adambdia/porch-light/README.md

# Porch Light Controller

My porch light drifts over time, getting out of sync. Probably because it's old. This is my attempt to IOT-ify it.
