adambdia/porch-light/pcb/porch-light-pcb.kicad_pcb

## KiCad design pcb/porch-light-pcb.kicad_pcb (2026-08-08)

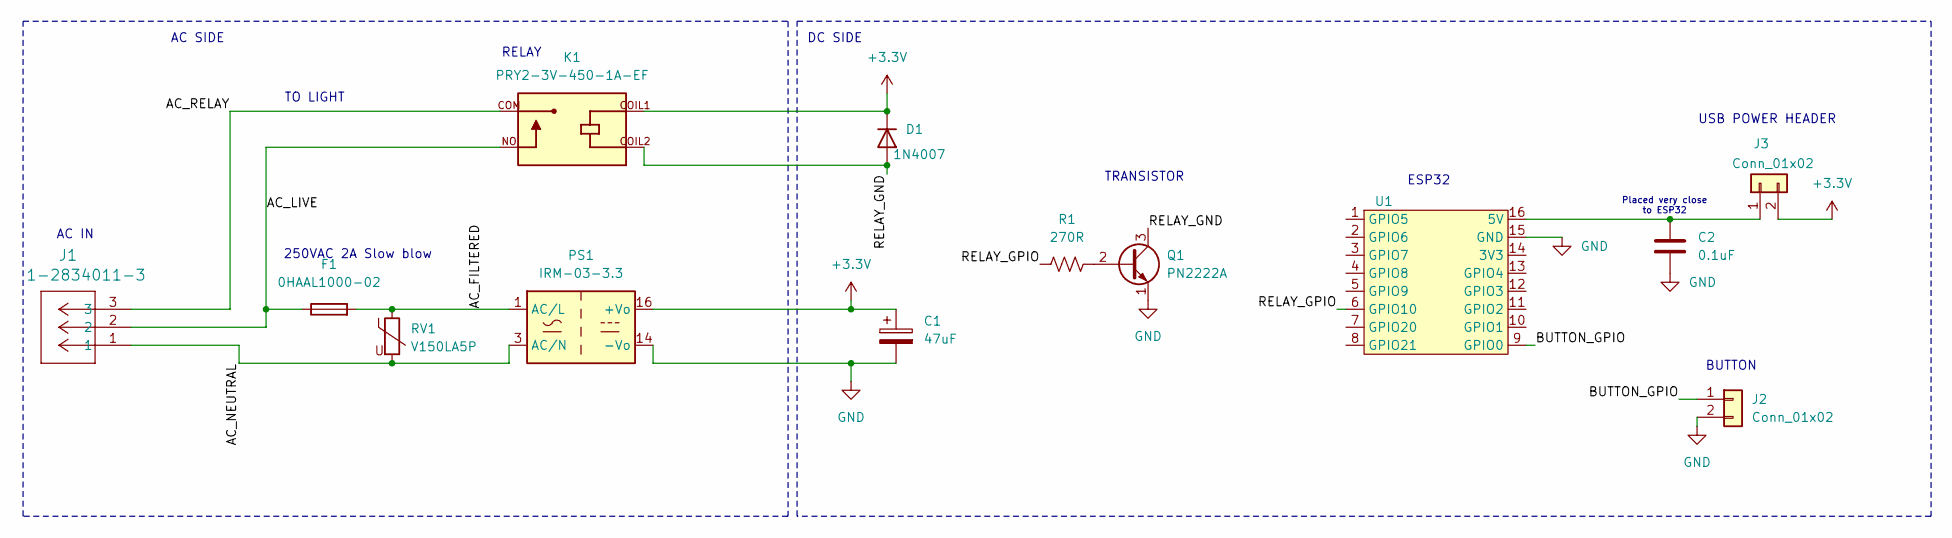
[picture p1: schematic porch-light-pcb.kicad_sch]

Parts:
C1: 47uF; CP_Radial_D4.0mm_P1.50mm
C2: 0.1uF; C_0603_1608Metric_Pad1.08x0.95mm_HandSolder
D1: 1N4007; D_SOD-123F
F1: 0HAAL1000-02; FUSRR508W60L840T400H810B
J1: 1-2834011-3; CONN_1-2834011-3_TEC
J2, J3: Conn_01x02; PinHeader_1x02_P2.54mm_Vertical
K1: PRY2-3V-450-1A-EF; RELAY_PRY2-3V-450-1A-EF; PARTREV 1.0
PS1: IRM-03-3.3; Converter_ACDC_MeanWell_IRM-03-xx_THT
Q1: PN2222A; TO-92_Inline
R1: 270R; R_Axial_DIN0207_L6.3mm_D2.5mm_P10.16mm_Horizontal
RV1: V150LA5P; RV_Disc_D12mm_W5.8mm_P7.5mm
U1: TENSTAR_ESP32-C3-SUPERMINI

Connections:
+3.3V: C1.1, D1.1 (K), J3.2, K1.COIL1, PS1.16 (+Vo)
/AC_FILTERED: F1.2, PS1.1 (AC/L), RV1.1
/AC_LIVE: F1.1, J1.2, K1.NO
/AC_NEUTRAL: J1.1, PS1.3 (AC/N), RV1.2
/AC_RELAY: J1.3, K1.COM
/BUTTON_GPIO: J2.1, U1.9 (GPIO0)
/RELAY_GND: D1.2 (A), K1.COIL2, Q1.3 (C)
/RELAY_GPIO: R1.1, U1.6 (GPIO10)
GND: C1.2, C2.1, J2.2, PS1.14 (-Vo), Q1.1 (E), U1.15 (GND)
unnamed: C2.2, J3.1, U1.16 (5V)
unnamed: Q1.2 (B), R1.2

Notes on the sheet:
RELAY
Placed very close to ESP32
TO LIGHT
DC SIDE
USB POWER HEADER
TRANSISTOR
AC SIDE
250VAC 2A Slow blow
ESP32
AC IN
BUTTON

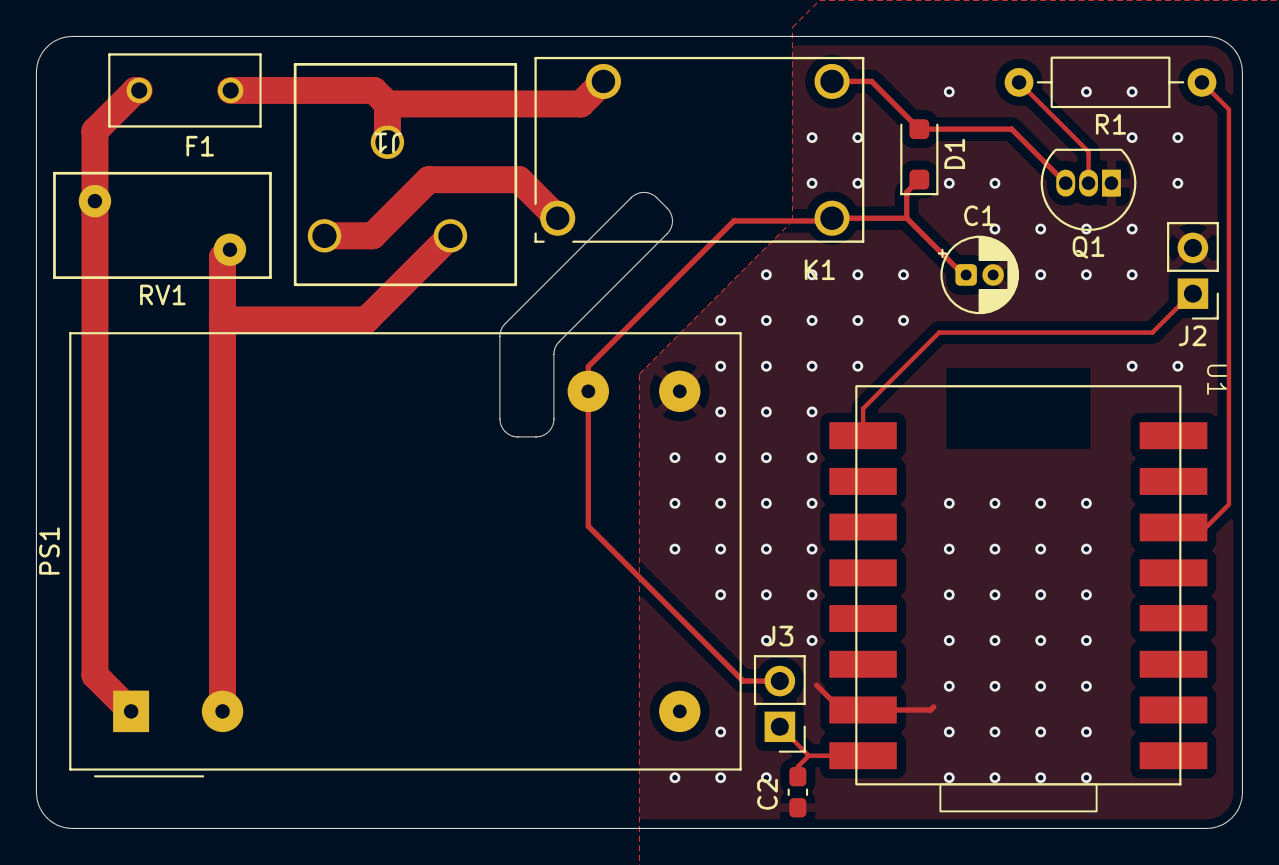
[picture p2: board porch-light-pcb.kicad_pcb from above]

Board: 2 copper layers, 67.0 x 44.0 mm, 13 parts (0 on the bottom side), 11 nets.
