adambdia/porch-light/fw/src/Light.cpp

#include "Light.h"
#include "esp32-hal-gpio.h"
#include "esp32-hal.h"
#include <Arduino.h>
#include <cstdint>

static int relayPin = 10;
static int LEDPin = 8; // onboard LED, for debug
static volatile bool scheduleLightEnabled = false;
static volatile uint32_t lightOverrideDuration = 10 * 60 * 1000; //  10 minutes
static volatile time_t lightOverrideExpireTime = 0;
static volatile bool lightOverrideEnabled = false;
static volatile uint32_t lastLightOverride = 0;

void initLight() {
  pinMode(relayPin, OUTPUT);
  pinMode(LEDPin, OUTPUT);
}

void turnOnLight() {
  digitalWrite(relayPin, HIGH);
  digitalWrite(LEDPin, LOW);
}

void turnOffLight() {
  digitalWrite(relayPin, LOW);
  digitalWrite(LEDPin, HIGH);
}

// these functions will eventually be called in Schedule.cpp
void scheduleLightOn() { scheduleLightEnabled = true; }
void scheduleLightOff() { scheduleLightEnabled = false; }

void overrideLight() {
  if (lightOverrideEnabled) {
    lightOverrideEnabled = false;
    return;
  }
  lightOverrideEnabled = true;
  lastLightOverride = millis();
}

void disableOverrideLight() { lightOverrideEnabled = false; }

bool getLightOverride() { return lightOverrideEnabled; }

bool getLightSchedule() { return scheduleLightEnabled; }

void setOverrideDuration(uint32_t duration) {
  lightOverrideDuration = duration;
}

void updateOverrideTimer() {
  if (millis() - lastLightOverride > lightOverrideDuration) {
    disableOverrideLight();
  }
}

void loopLight() {
  updateOverrideTimer();
  bool overrideActive = getLightOverride();
  bool scheduleActive = getLightSchedule();
  // The concensus, turn on the light if one or the other is on
  bool decision = overrideActive || scheduleActive;

  if (decision)
    turnOnLight();
  else
    turnOffLight();
}
