adambdia/porch-light/(commit log)

2026-08-05 created kicad project
    [porch-light-pcb.kicad_pcb, porch-light-pcb.kicad_sch]
2026-08-05 esp32 symbol and footprint
    [porch-light-pcb.kicad_sch]
2026-08-06 preliminary circuit design
    [porch-light-pcb.kicad_pcb, porch-light-pcb.kicad_sch]
2026-08-06 relay_gpio connection
    [porch-light-pcb.kicad_sch]
2026-08-06 terminal block chosen
    [porch-light-pcb.kicad_sch]
2026-08-06 footprint assignment
    [porch-light-pcb.kicad_pcb, porch-light-pcb.kicad_sch]
2026-08-07 intial board layout, chose some smaller parts
    [porch-light-pcb.kicad_pcb, porch-light-pcb.kicad_sch]
2026-08-07 fixed netclasses
    [porch-light-pcb.kicad_pcb, porch-light-pcb.kicad_sch]
2026-08-07 finished routing
    [porch-light-pcb.kicad_pcb, porch-light-pcb.kicad_sch]
2026-08-07 updated gitignore
    [porch-light-pcb.kicad_pcb, porch-light-pcb.kicad_sch]
2026-08-07 updated gitignore, add stiching vias
    [porch-light-pcb.kicad_pcb, porch-light-pcb.stl]
2026-08-08 created freecad project
    [enclosure.FCStd, porch-light-pcb.kicad_pcb, porch-light-pcb.kicad_sch]
2026-08-08 test part to check light switch cover fit
    [enclosure-Mount.stl, enclosure.FCStd]
2026-08-08 added flyback diode to relay
    [porch-light-pcb.kicad_pcb, porch-light-pcb.kicad_sch]
2026-08-08 swapped 220uF for 47uF, added jumper to disable USB power
    [porch-light-pcb.kicad_pcb, porch-light-pcb.kicad_sch]
2026-08-09 added all CAD to gitignore
    [enclosure-Mount.stl, enclosure.FCStd]
2026-08-09 untrack hw
    [enclosure-Mount.stl, enclosure.FCStd, porch-light-pcb.stl]
2026-08-12 button now overrides schedule, created schedule.h and cpp (basically empty)
2026-08-12 created Button.h and cpp
2026-08-13 added ArduinoJSON
2026-08-19 onboard LED is now for debug, actual relay pin now used
2026-08-21 correctly debouncing button
